BiaPopa/Omnia/hardware/Omnia_PLC_Components.xlsx

Sheet: Componente
Category | Device | Value | Qty | Link
Capacitors | Ceramic capacitors - 0.1UF-0402-16V-10% | 0.1uF | 17 | https://ro.mouser.com/ProductDetail/80-C0402C104K4R7411
 | Ceramic capacitors - 1.0UF-0603-16V-10% | 1.0uF | 1 | https://ro.mouser.com/ProductDetail/963-EMK107B7105KA8T
 | Ceramic capacitors - 4.7UF-0603-6.3V-(10%) | 4.7uF | 1 | https://ro.mouser.com/ProductDetail/TDK/CGA3E1X5R0J475K080AC?qs=NRhsANhppD%2FXGKZ5N5lDCw%3D%3D
 | Aluminium Electrolytic Capacitors - SMD WCAP-ASLL 100uF 50V 20% | 100uF | 1 | https://ro.mouser.com/ProductDetail/Wurth-Elektronik/865060653010?qs=0KOYDY2FL2%252BoVBl9%252BvxW%2Fg%3D%3D
 | Aluminium Electrolytic Capacitors - SMD WCAP-AS5H 330uF 50V 20% | 330uF | 1 | https://ro.mouser.com/ProductDetail/Wurth-Elektronik/865230657014?qs=amGC7iS6iy8zviggKveCLg%3D%3D
Resistors | SMD-RES-10K-1%-1/10W(0603) | 10KΩ | 19 | https://ro.mouser.com/ProductDetail/Vishay-Dale/CRCW060310K0FKEI
 | SMD-RES-1K-1%-1/10W(0603) | 1KΩ | 2 | https://ro.mouser.com/ProductDetail/Vishay-Dale/CRCW06031K00FKEA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
 | 1KOHM-0402T-1/16W-1% | 1KΩ | 6 | https://ro.mouser.com/ProductDetail/Vishay-Dale/CRCW04021K00FKTE
 | 220OHM-0603-1/10W-1% | 220Ω | 6 | https://ro.mouser.com/ProductDetail/Vishay-Dale/CRCW0603220RFKEC
 | 120OHM-0603-1/10W-1% | 120Ω | 1 | https://ro.mouser.com/ProductDetail/Vishay-Dale/CRCW0603120RFKEA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
 | SMD-RES-56R-1%-1/10W(0603) | 56Ω | 12 | https://ro.mouser.com/ProductDetail/KOA-Speer/RK73H1HRTTCM56R0F?qs=ZcfC38r4Pov2XajrmjAU9Q%3D%3D
 | 3.3KOHM-0603-1/10W-1% | 3.3k | 1 | https://ro.mouser.com/ProductDetail/Vishay-Dale/CRCW06033K30FKEBC
 | 33KOHM-0402T-1/16W-1% | 33k | 6 | https://ro.mouser.com/ProductDetail/Vishay-Dale/CRCW040233K0FKEDC
 | 5.1KOHM-0402T-1/16W-1% | 5.1k | 2 | https://ro.mouser.com/ProductDetail/Vishay-Dale/CRCW04025K10FKEDC
 | 68.1KOHM-0603-1/10W-1% | 68.1k | 6 | https://ro.mouser.com/ProductDetail/Bourns/CR0603-FX-6812ELF
Diodes | Schottky Diodes & Rectifiers 1N5819HW-7-F | 1A, 40V | 3 | https://ro.mouser.com/ProductDetail/Diodes-Incorporated/1N5819HW-7-F?qs=NQ47qNm99eDyWTEd07miYA%3D%3D
 | Zener Diodes DDZ9684-7 | 500MW, 3.3V | 6 | https://ro.mouser.com/ProductDetail/Diodes-Incorporated/DDZ9684-7?qs=mQbszxtPdlN5OVpmKRGZYw%3D%3D
 | LED HLMP-NG07 | RED | 12 | https://ro.mouser.com/ProductDetail/Broadcom-Avago/HLMP-NG07
 | Schottky Diodes & Rectifiers SS34 | 3A, 40V | 1 | https://ro.mouser.com/ProductDetail/Taiwan-Semiconductor/SS34?qs=JV7lzlMm3yIimVqgKV%2F1SA%3D%3D
Switches & Buttons | SPARKFUN-SWITCHES_MOMENTARY-SWITCH-SPST-2-SMD-4.6X2.8MM | BUTTON | 2 | https://ro.mouser.com/ProductDetail/CK/KMR431G-ULC-LFS?qs=3gW96gqhLbqDi19gDC%2FKtg%3D%3D
 | Power Switch ICs - Power Distribution ITS4100S-SJ-N | 5 V to 34 V | 3 | https://ro.mouser.com/ProductDetail/Infineon-Technologies/ITS4100S-SJ-N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
Relays | SRD-24VDC-SL-C | 24V, 10A | 3 | https://jlcpcb.com/partdetail/Ningbo_SongleRelay-SRD_24VDC_SLC/C15840
Transistors | Bipolar Transistors BC846-T | 0.1A, 65V | 12 | https://ro.mouser.com/ProductDetail/Rectron/BC846-T?qs=Pkg3F8W3dt6cUIu%2FpkDz7A%3D%3D
Multiprotocol Modules | ESP32-C6-WROOM-1U-N4 |  | 1 | https://ro.mouser.com/ProductDetail/Espressif-Systems/ESP32-C6-WROOM-1U-N4?qs=Imq1NPwxi74mh1MmrGnEKA%3D%3D
Inductors (Coils) | RF Inductors 744766920 | 100uH, 275mA, 372mOhms | 1 | https://ro.mouser.com/ProductDetail/Wurth-Elektronik/744766920?qs=HXx4m3XcTe2Xvw4swesQ4A%3D%3D
Power Supply & Battery | Coin Cell Battery Holders Linx CR2032 BAT-HLD-001-TR |  | 1 | https://ro.mouser.com/ProductDetail/TE-Connectivity-Linx-Technologies/BAT-HLD-001-TR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
 | CR2032 Battery |  | 1 | https://ro.mouser.com/ProductDetail/Panasonic-Industrial-Devices/CR-2032-HEN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
 | DIN Rail Power Supplies EDR-120-24 | 120W, 24V, 5A | 1 | https://ro.mouser.com/ProductDetail/MEAN-WELL/EDR-120-24?qs=5aQ9wn8iLe%252B0m5OrEtInbA%3D%3D
Enclosure | Carcasă pentru şină DIN ZD1010J ABS V0 | Y: 89mm; X: 177mm; Z: 65mm | 1 | https://www.tme.eu/ro/details/zd1010j-abs-v0/carcase-montare-pe-sina-din/kradex/zd1010j-abs-v0/
 | Capac de protecţie ZDFJ1010 ABS V0 |  | 1 | https://www.tme.eu/ro/details/zdfj1010-abs-v0/accesorii-pentru-carcase-pentru-sina-din/kradex/zdfj1010-abs-v0/
 | Protecţie borne ZD5TC 5,08 ABS V0 |  | 1 | https://www.tme.eu/ro/details/zd5tc-5.08-abs-v0/accesorii-pentru-carcase-pentru-sina-din/kradex/zd5tc-5-08-abs-v0/
 | Capac de protecţie ZDPLUG 5,08 ABS V0 |  | 1 | https://www.tme.eu/ro/details/zdplug-5.08-abs-v0/accesorii-pentru-carcase-pentru-sina-din/kradex/zdplug-5-08-abs-v0/
Antenna | Antennas RF ANT-W63WS5-SMA |  | 1 | https://ro.mouser.com/ProductDetail/TE-Connectivity-Linx-Technologies/ANT-W63WS5-SMA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
 | Cablu IPEX-SMA-150 |  | 1 | https://www.tme.eu/ro/details/ipex-sma-150/conectare-cabluri-coaxiale/onteck/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
Communication Modules | RS-485 half duplex MAX3485CSA+ |  | 1 | https://www.tme.eu/ro/details/max3485csa+/circuite-integrate-rs232-rs422-rs485/analog-devices-maxim-integrated/
 | USB Connectors USB Type C USB4110-GF-A |  | 1 | https://ro.mouser.com/ProductDetail/GCT/USB4110-GF-A?qs=KUoIvG%2F9IlYiZvIXQjyJeA%3D%3D
Circuit Protection | ESD Protection Diodes / TVS Diodes 8 CH EMI7208MUTAG |  | 2 | https://ro.mouser.com/ProductDetail/onsemi/EMI7208MUTAG?qs=UikTwjRNStJq1uo70cwiCA%3D%3D
 | ESD Protection Diodes / TVS Diodes ESD Protection Low Cap USBLC6-2SC6 |  | 1 | https://ro.mouser.com/ProductDetail/STMicroelectronics/USBLC6-2SC6?qs=po45yt2pPpu%2FhNIlwQdTlg%3D%3D
 | Supervisory Circuits CMOS BD5229G-TR | 2.3V to 6.0V | 1 | https://ro.mouser.com/ProductDetail/ROHM-Semiconductor/BD5229G-TR?qs=4kLU8WoGk0vvnhrrYwdszw%3D%3D
 | Resettable Fuses - PPTC 6V POLYFUSE 0603L050SLYR | Hold current: 500 mA, Trip current: 1A | 1 | https://ro.mouser.com/ProductDetail/Littelfuse/0603L050SLYR
 | Resettable Fuses - PPTC 6V POLYFUSE 0805L200SLTHYR | Hold current: 2A, Trip current: 4A | 1 | https://ro.mouser.com/ProductDetail/Littelfuse/0805L200SLTHYR?qs=l%252BmC%252BYUP1cqCIkGjjBrLUw%3D%3D
Memory & Storage | NOR Flash spiFlash W25Q512JVEIQ | 512M-bit | 1 | https://ro.mouser.com/ProductDetail/Winbond/W25Q512JVEIQ?qs=l7cgNqFNU1jw6svr3at6tA%3D%3D
Others | Circuit RTC DS3231SN# | 2,3V to 5,5V | 1 | https://www.tme.eu/ro/details/ds3231sn/circuite-rtc/analog-devices-maxim-integrated/ds3231sn/
 | Multiplexer Switch ICs 8-channel analog multiplexer/demultiplexer 74HC4051D,653 | 2V to 10V | 1 | https://ro.mouser.com/ProductDetail/Nexperia/74HC4051D653
 | Expansion port - Modular Connectors / Ethernet Connectors 44620-0002 |  | 1 | https://ro.mouser.com/ProductDetail/Molex/44620-0002?qs=%2F%2FRC%2FV59VWAflICSfNN4Pw%3D%3D
 | Fixed Terminal Blocks TB009-508-02BE |  | 7 | https://ro.mouser.com/ProductDetail/Same-Sky/TB009-508-02BE?qs=vLWxofP3U2wCFk5uCkWTkA%3D%3D
 | Fixed Terminal Blocks TB009-508-03BE |  | 3 | https://ro.mouser.com/ProductDetail/Same-Sky/TB009-508-03BE?qs=vLWxofP3U2zvTycU48uTVg%3D%3D
 | Switching Voltage Regulators 3A Step-Down SMPS Regulator LM2576-3.3WU-TR | 3.3V | 1 | https://ro.mouser.com/ProductDetail/Microchip-Technology/LM2576-3.3WU-TR?qs=Y3Q3JoKAO1RTy9zyf5BX%252Bw%3D%3D

Sheet: Consum maxim
ESP32 C6 WROOM | 382 | mA
 | 1 | mA
Input EMI filter with ESD protection | 19.8 | mA
Input LED indicators | 37.2 | mA
 | 4.8 | mA
Output EMI filter with ESD protection | 90 | mA
Output LED indicators | 37.2 | mA
Output relays with high side switch | 0.99 | mA
 | 3.9 | mA
External NOR Flash | 30 | mA
 | 40 | mA
Internal RTC | 0.33 | mA
 | 0.65 | mA
Voltage supervisor | 0.664 | mA
Input MUX | 200 | mA
RS-485 communication | 35 | mA
 | 883.534 | mA
