BiaPopa/Omnia/(list of files, cad)

Other CAD files:
hardware/SecondBoard/Omnia_SecondBoard.f3d
