BiaPopa/Omnia/software/ArduinoIDE/functionality_tests/EXTERNAL_ANTENNA_test/EXTERNAL_ANTENNA_test.ino

#include <WiFi.h>

void setup() {
  Serial.begin(115200);
  delay(3000);
  
  Serial.println("Scanning WiFi...");
  int n = WiFi.scanNetworks();
  Serial.println("Scan complete");
  
  if (n == 0) {
    Serial.println("No networks found");
  } else {
    for (int i = 0; i < n; ++i) {
      Serial.print(i + 1);
      Serial.print(": ");
      Serial.print(WiFi.SSID(i));
      Serial.print(" (RSSI: ");
      Serial.print(WiFi.RSSI(i));
      Serial.println(" dBm)");
    }
  }
}

void loop() {}
