BiaPopa/Omnia/software/ArduinoIDE/functionality_tests/INPUT_A1_test/INPUT_A1_test.ino

const int muxSelectPins[] = {1, 8, 11};  
const int muxInputPin = 5;  

void setup() {
  Serial.begin(115200);
  delay(3000);

  for (int i = 0; i < 3; i++) 
    pinMode(muxSelectPins[i], OUTPUT);
  pinMode(muxInputPin, INPUT); 
  
  digitalWrite(muxSelectPins[0], 1);
  digitalWrite(muxSelectPins[1], 1);
  digitalWrite(muxSelectPins[2], 0);

  Serial.println("Test A1 started");
}

void loop() {
  int val = analogRead(muxInputPin);

  Serial.print("A1: ");
  Serial.println(val);

  delay(500);
}
