BiaPopa/Omnia/software/ArduinoIDE/functionality_tests/RTC_test/RTC_test.ino

#include <Wire.h>
#include "RTClib.h"

RTC_DS3231 rtc;

void setup() {
  Serial.begin(115200);
  delay(3000);
  
  Wire.begin(22, 23);  

  if (!rtc.begin()) {
    Serial.println("RTC not found");
    while (1);
  }

  if (rtc.lostPower()) {
    Serial.println("RTC lost power, setting default time...");
    rtc.adjust(DateTime(F(__DATE__), F(__TIME__)));
  }

  Serial.println("RTC Test started");
}

void loop() {
  DateTime now = rtc.now();

  Serial.print("Time: ");
  Serial.print(now.year()); Serial.print('/');
  Serial.print(now.month()); Serial.print('/');
  Serial.print(now.day()); Serial.print(" ");
  Serial.print(now.hour()); Serial.print(':');
  Serial.print(now.minute()); Serial.print(':');
  Serial.println(now.second());

  delay(1000);
}
