BiaPopa/Omnia/(commit log)

2025-06-05 Add components
    [Omnia_PLC_Components.xlsx]
2025-06-13 Add ST to Arduino converter
    [Omnia_PLC_Components.xlsx]
2025-06-13 Add hardware solution
    [Omnia_SecondBoard.f3d]
2025-06-13 Add Omnia board support for PlatformIO
